dventurb/ASRS-Automated-Storage/Pictures/Diagrams and Schematics/Flowchart_Arduino.png

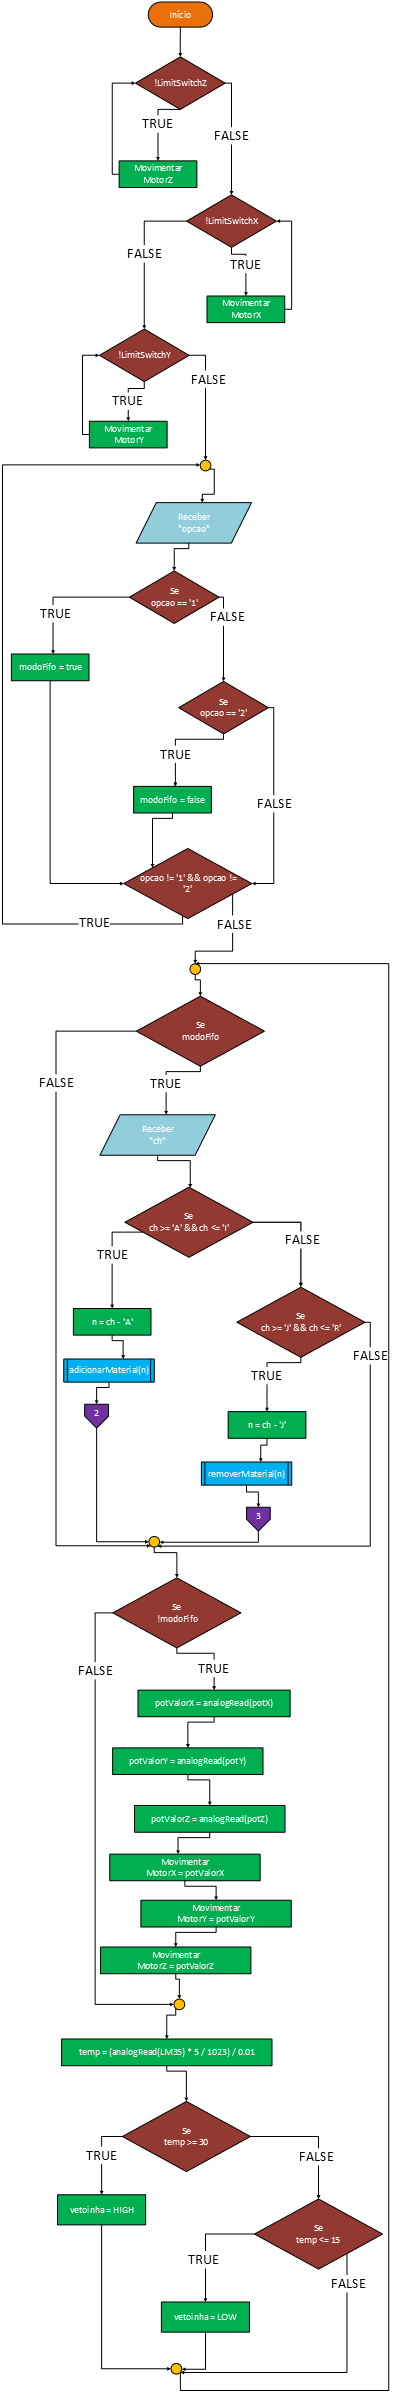
Pictures/Diagrams and Schematics/Flowchart_Arduino.png
