dventurb/ASRS-Automated-Storage/Pictures/Prototype/ASRS_Full.png

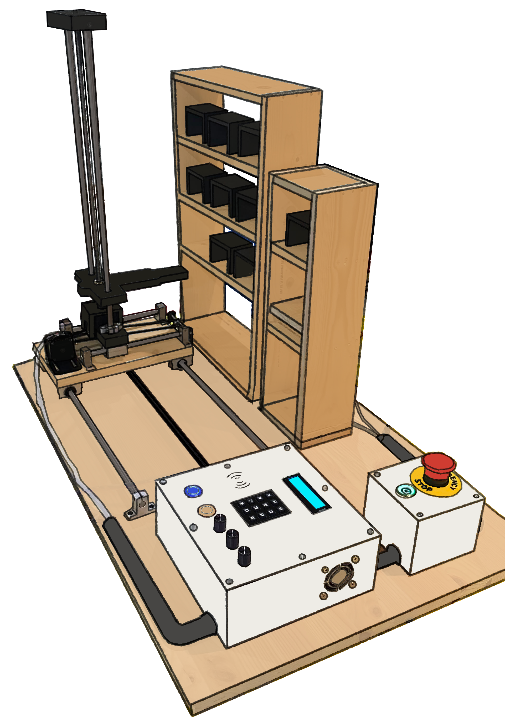
Pictures/Prototype/ASRS_Full.png
