dventurb/ASRS-Automated-Storage/Pictures/Prototype/ASRS_With_Rack.png

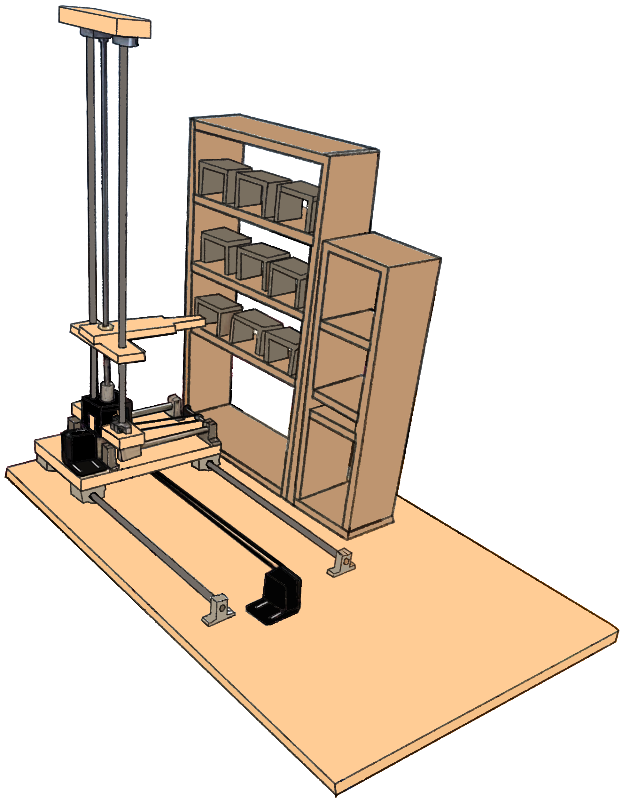
Pictures/Prototype/ASRS_With_Rack.png
