dventurb/ASRS-Automated-Storage/Pictures/Prototype/EntryExitStation_WeightCell.png

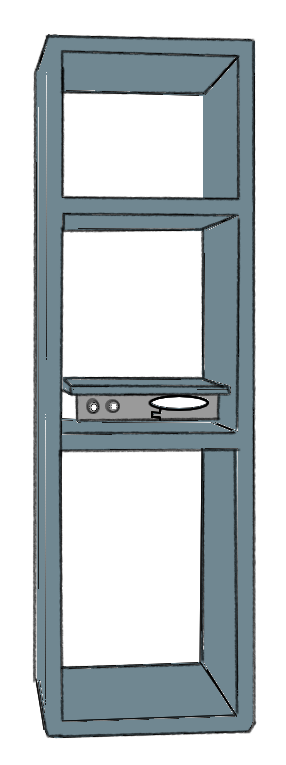
Pictures/Prototype/EntryExitStation_WeightCell.png
