dventurb/ASRS-Automated-Storage/Pictures/Prototype/Lifter_With_Magnet.png

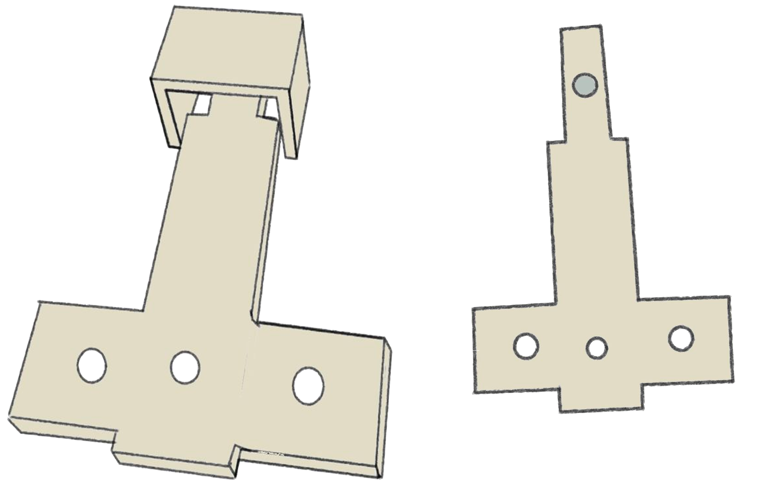
Pictures/Prototype/Lifter_With_Magnet.png
