dventurb/ASRS-Automated-Storage/Pictures/Prototype/Pallet_Design.png

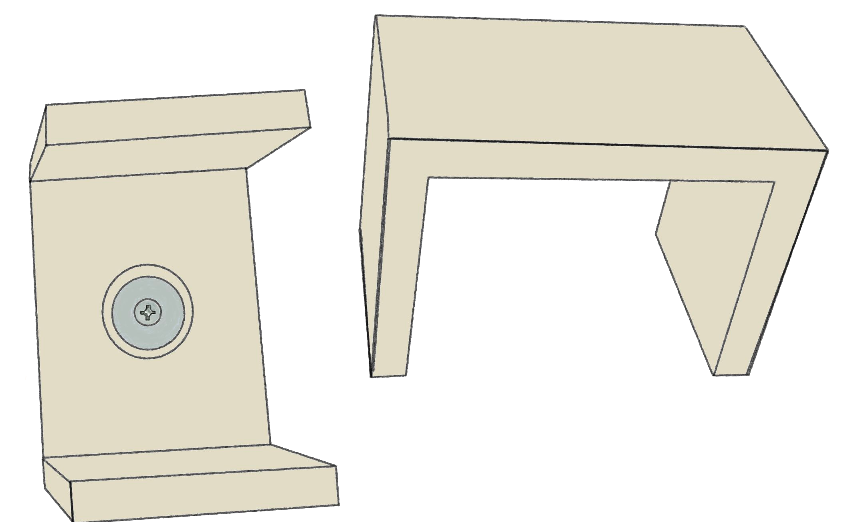
Pictures/Prototype/Pallet_Design.png
