dventurb/ASRS-Automated-Storage/Pictures/Prototype/Rack4x3.png

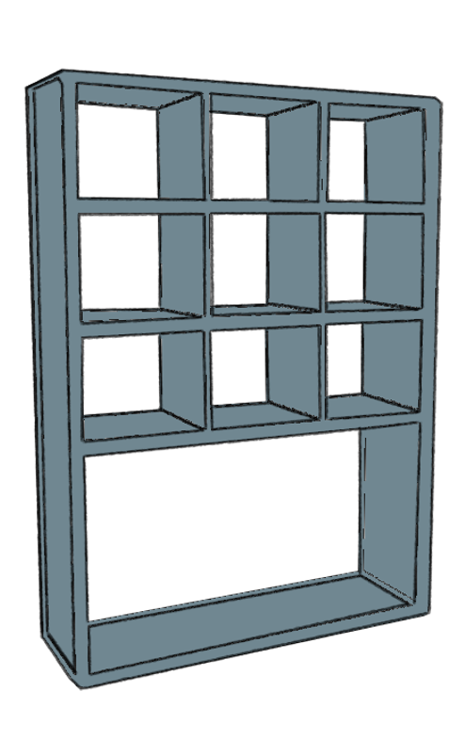
Pictures/Prototype/Rack4x3.png
