dventurb/ASRS-Automated-Storage/Pictures/Diagrams and Schematics/Flowchart_adicionarMaterial.png

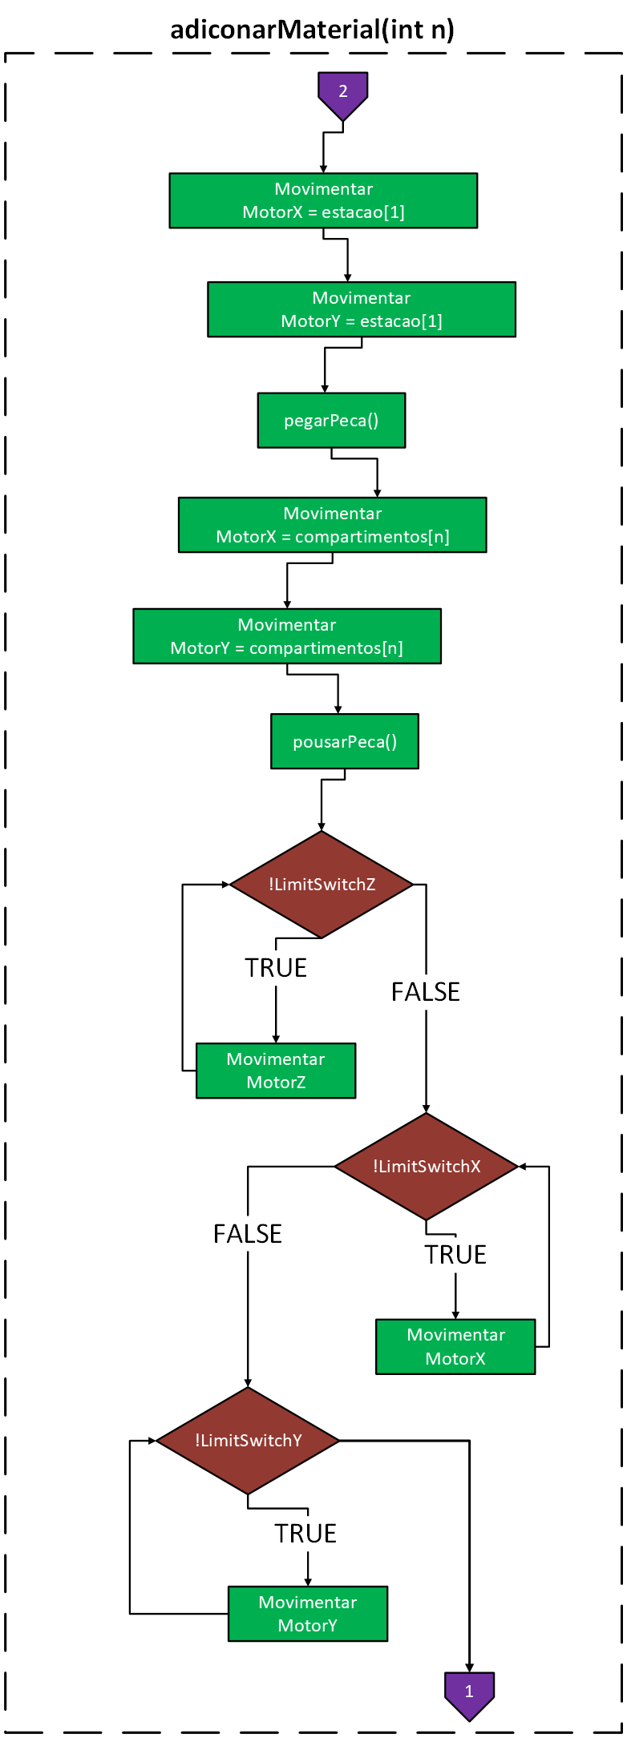
Pictures/Diagrams and Schematics/Flowchart_adicionarMaterial.png
