dventurb/ASRS-Automated-Storage/Electronics/Schematic_BlackAndWhite.pdf

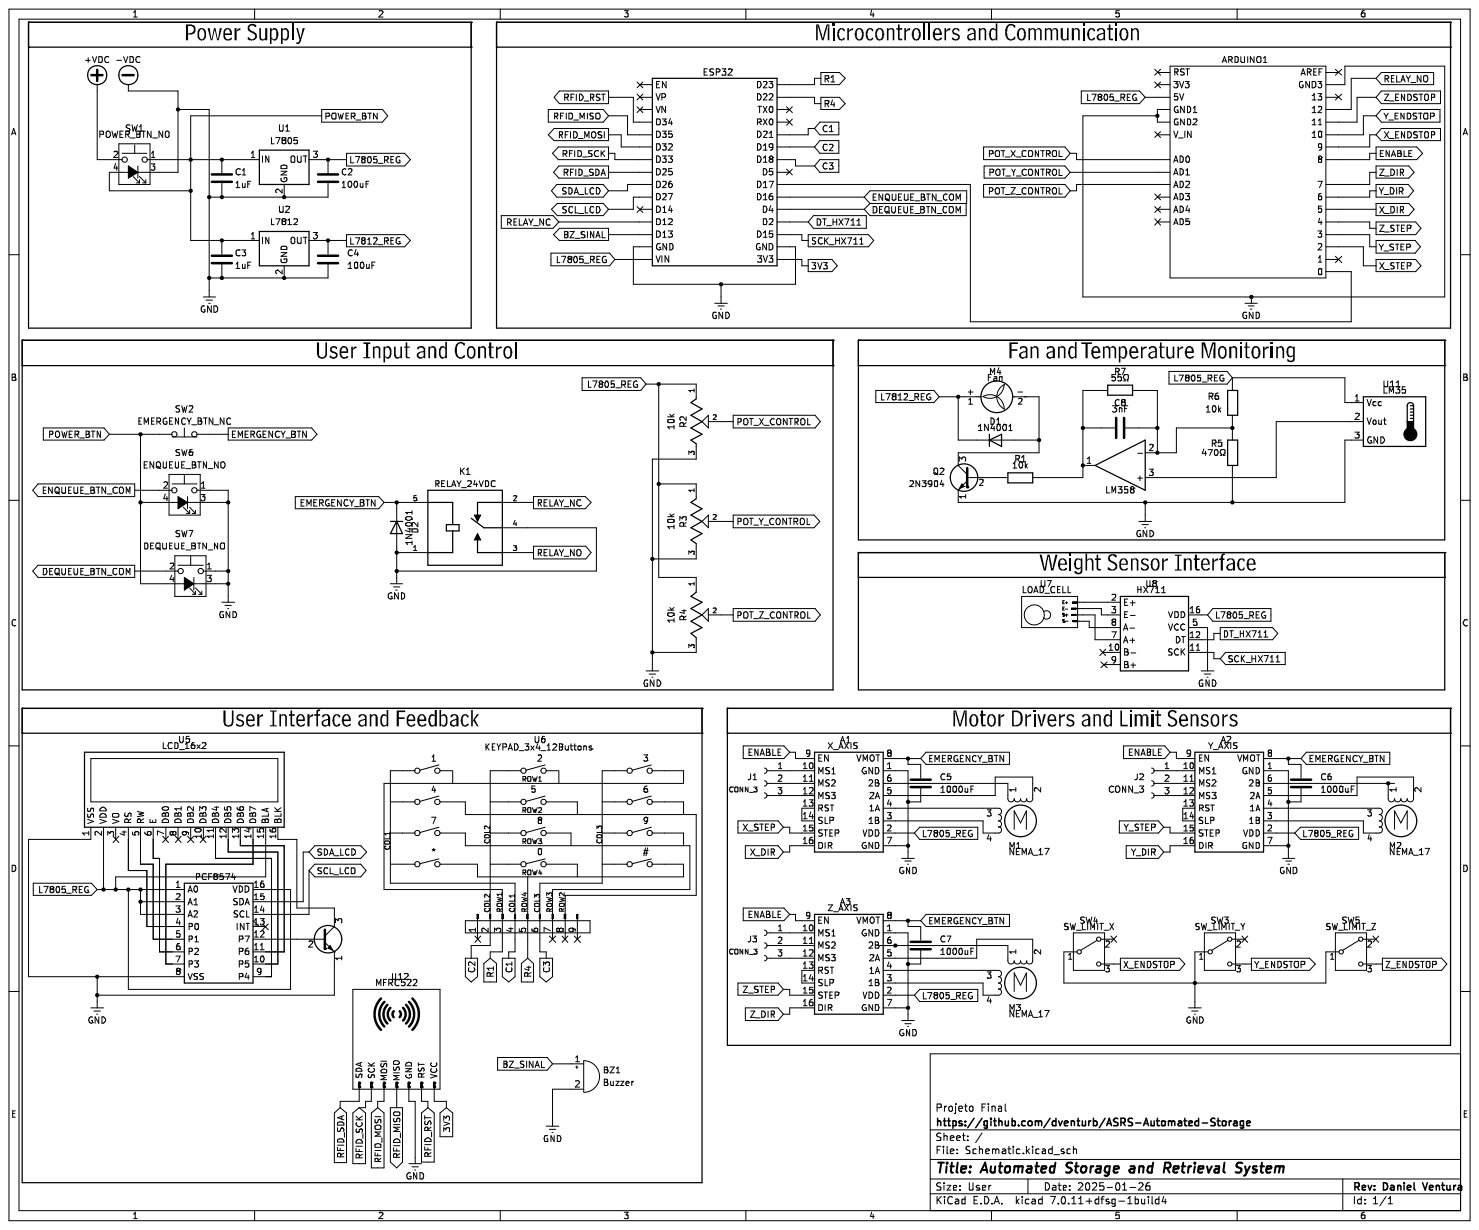
[picture p18: page 1]
