dventurb/ASRS-Automated-Storage/Electronics/Schematic_Colours.pdf

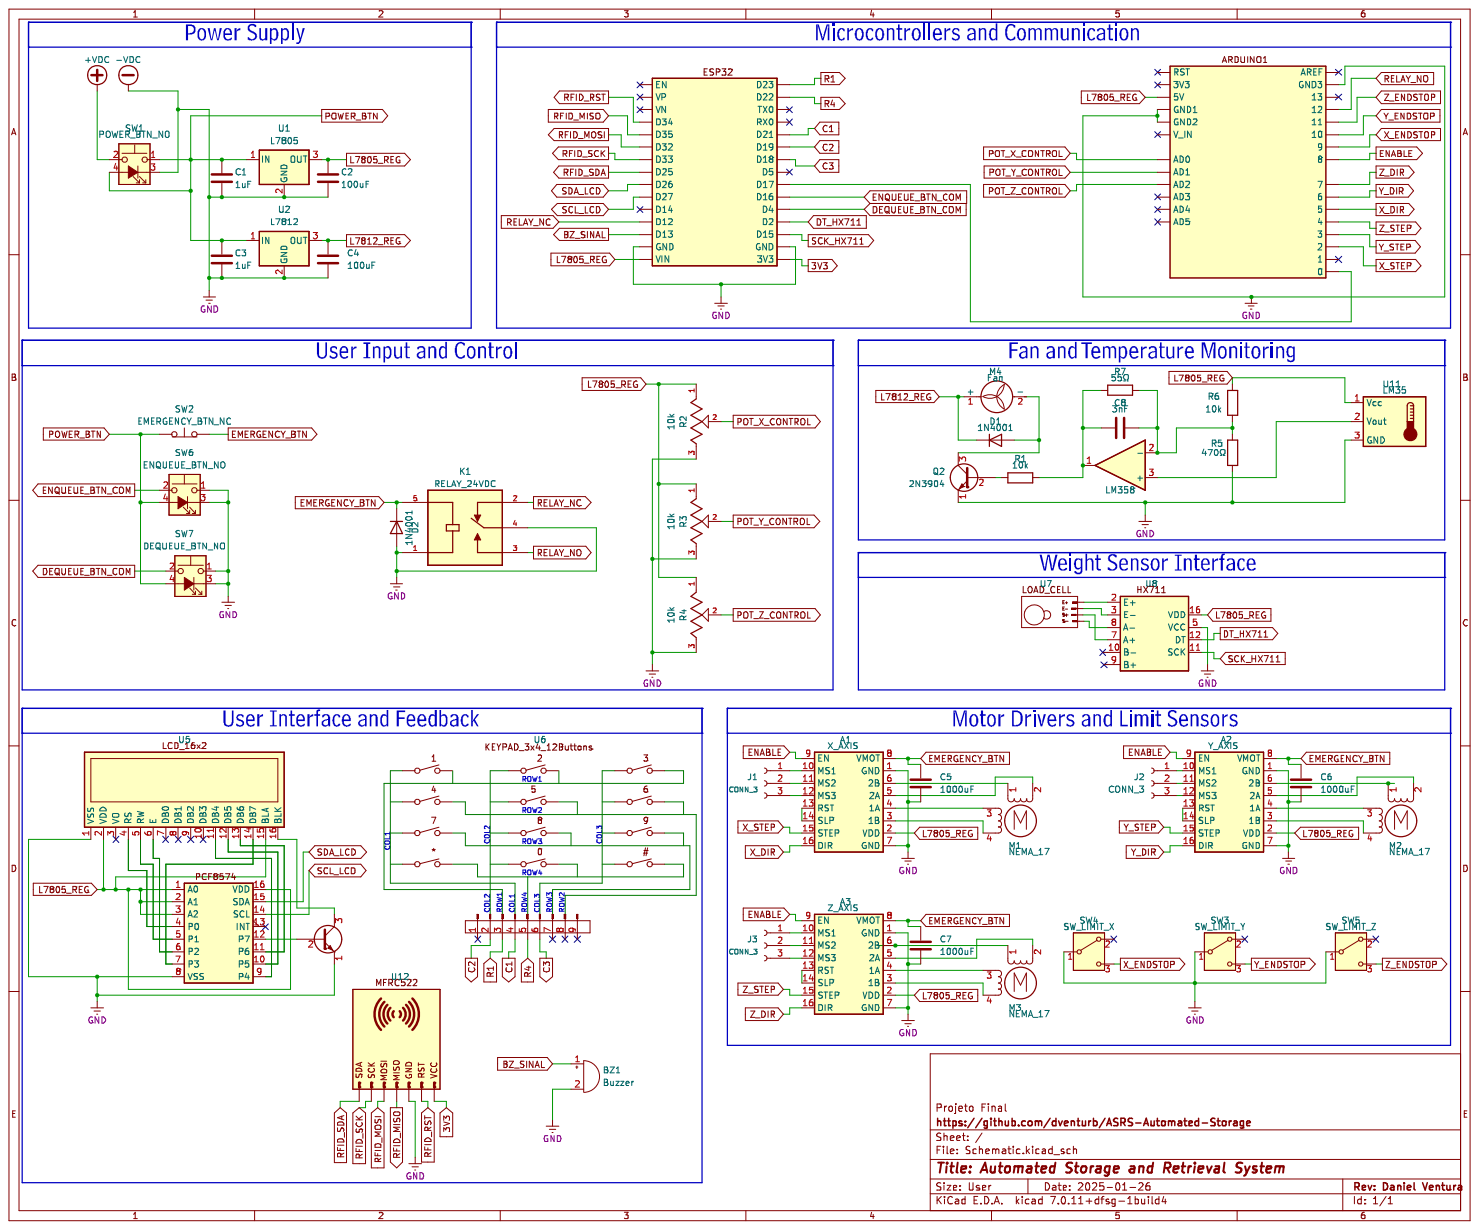
[picture p19: page 1]
