dventurb/ASRS-Automated-Storage/(commit log)

2025-02-04 💻 Código para ESP32, Arduino e fluxogramas.
2025-02-04 💻 Código para ESP32, Arduino e fluxogramas.
2025-02-11 🔌 Circuits & Connections
2025-02-28 📸 Project images and diagrams
2025-02-28 📖 README.md
2025-02-28 🗂️ Documentation
